lukmatuska/WaveLight/WaveLight_power.drawio.png

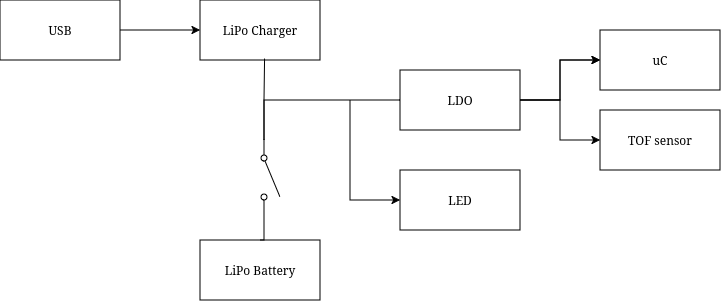
WaveLight_power.drawio.png
