lukmatuska/WaveLight/WaveLight_power.drawio_light.png

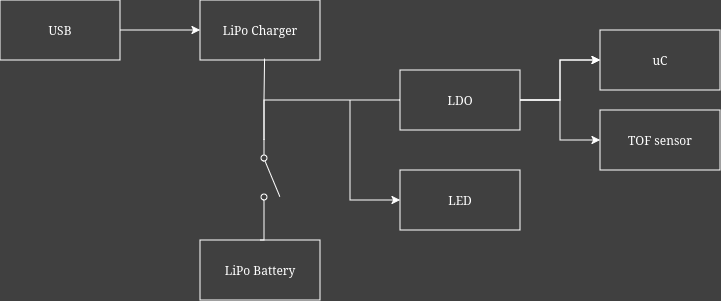
WaveLight_power.drawio_light.png
