lukmatuska/WaveLight/WaveLight.kicad_pcb

## KiCad design WaveLight.kicad_pcb (2026-05-11)

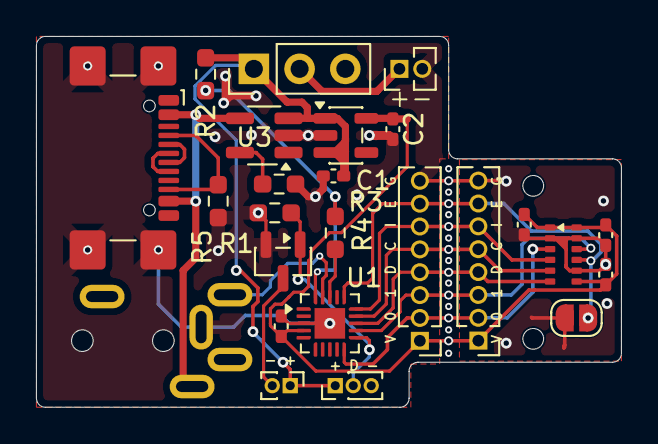
[picture p3: board WaveLight.kicad_pcb from above]

Board: 2 copper layers, 32.5 x 20.6 mm, 25 parts (1 on the bottom side), 20 nets.

Parts:
C1, C2: 100n; C_0402_1005Metric_Pad0.74x0.62mm_HandSolder
C3, C4, C5, C6: 0.1u; C_0402_1005Metric_Pad0.74x0.62mm_HandSolder
J1: AudioJack4_SwitchT1; ASJ-190-A
J2: Ledstrip_conn; PinHeader_1x03_P1.00mm_Vertical
J3: PowerLED_conn; PinHeader_1x02_P1.00mm_Vertical
J4, J5: Conn_01x08_Pin; PinHeader_1x08_P1.27mm_Vertical
J6: Batt; PinHeader_1x02_P1.27mm_Vertical
J7: USB_C_Receptacle_USB2.0_14P; USB_C_Receptacle_GCT_USB4110
JP1: SolderJumper_2_Open; SolderJumper-2_P1.3mm_Open_RoundedPad1.0x1.5mm
Q1: AO3400A or similar; SOT-23
R1: 10k; R_0603_1608Metric_Pad0.98x0.95mm_HandSolder
R2: 1M; R_0603_1608Metric_Pad0.98x0.95mm_HandSolder
R3: CH_PROG; R_0603_1608Metric_Pad0.98x0.95mm_HandSolder
R4: 470K; R_0603_1608Metric_Pad0.98x0.95mm_HandSolder
R5: 56k; R_0603_1608Metric_Pad0.98x0.95mm_HandSolder
SW1: POWER_SW_SPDT; PinHeader_1x03_P2.54mm_Vertical
TCR2Lx1: TCR2Lx1; SOT-23-5
U1: ATtiny416-M; VQFN-20-1EP_3x3mm_P0.4mm_EP1.7x1.7mm
U2: TMF8801
U3: TP charger; SOT-23-5_HandSoldering

Connections:
/BV_GND: R4.2, U1.18 (PC3)
/BV_meas: R2.2, R4.1, U1.20 (PA1)
/DM: J7.A7 (D-), J7.B7 (D-)
/DP: J7.A6 (D+), J7.B6 (D+)
/EN: J4.7, J5.7, JP1.2 (B), U1.16 (PC1), U2.9 (EN)
/GP0: J4.2, J5.2, U1.10 (PB4), U2.3 (GPIO0)
/GP1: J4.3, J5.3, U1.12 (PB2), U2.10 (GPIO1)
/INT: J4.6, J5.6, U1.15 (PC0), U2.4 (INT)
/SCL: J4.5, J5.5, U1.14 (PB0), U2.5 (SCL)
/SDA: J4.4, J5.4, U1.13 (PB1), U2.6 (SDA)
/UPDI: J1.R1, U1.19 (~RESET/PA0)
/led_RGB: J2.2, Q1.1 (G), R1.1, U1.11 (PB3)
GND: C1.2, C2.2, C3.2, C4.2, C5.2, C6.2, J1.S, J2.3, J4.8, J5.8, J6.2, J7.A1 (GND), J7.A12 (GND), J7.B1 (GND), J7.B12 (GND), J7.S1 (SHIELD), JP1.1 (A), Q1.2 (S), R1.2, R3.2, R5.2, TCR2Lx1.2 (GND), U1.3 (GND), U1.21 (GND), U2.2 (GNDC), U2.8 (GND), U2.11 (GND), U3.2 (GND)
unnamed: J3.2, Q1.3 (D)
unnamed: J6.1, SW1.2 (B)
unnamed: J7.A5 (CC1), J7.B5 (CC2), R5.1
unnamed: R3.1, U3.5 (PROG)
VBUS: C1.1, J2.1, J3.1, R2.1, SW1.1 (A), TCR2Lx1.1 (Vin), TCR2Lx1.3 (Control), U3.3 (BAT)
VDC: J1.T, J7.A4 (VBUS), J7.A9 (VBUS), J7.B4 (VBUS), J7.B9 (VBUS), U3.4 (Vcc)
VDD: C2.1, C3.1, C4.1, C5.1, C6.1, J4.1, J5.1, TCR2Lx1.5 (Vout), U1.4 (VCC), U2.1 (VDDC), U2.7 (VDD), U2.12 (VDDV)
