lukmatuska/WaveLight/(commit log)

2026-10-23 power management estimation
2026-10-23 lowered idle power draw
2026-10-25 added staggered led mapping
